SmartLogicUA/Access-Control-Lite/images/access_control_lite.jpg

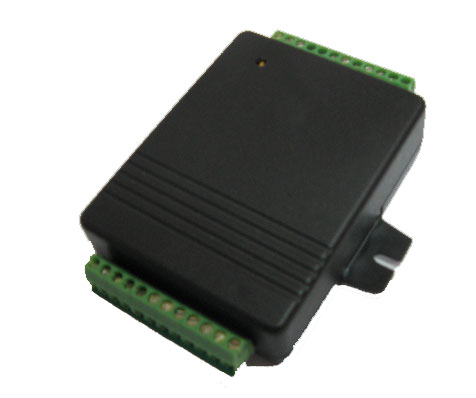
images/access_control_lite.jpg
