SmartLogicUA/Access-Control-Lite/(list of files, drawings)

Other design files:
scheme/PCAD/v1.2.X.pcb
scheme/PIC/v1.2.1_TOP.pcb
scheme/PIC/v1.2.2_TOP.pcb
scheme/PIC/v1.2.X_TOP.pcb
